ProjectKitchen/BrailleDisplay/CAD Drawings/Braille Cell V2/Combined/ExplodedAssembly_3.FCStd

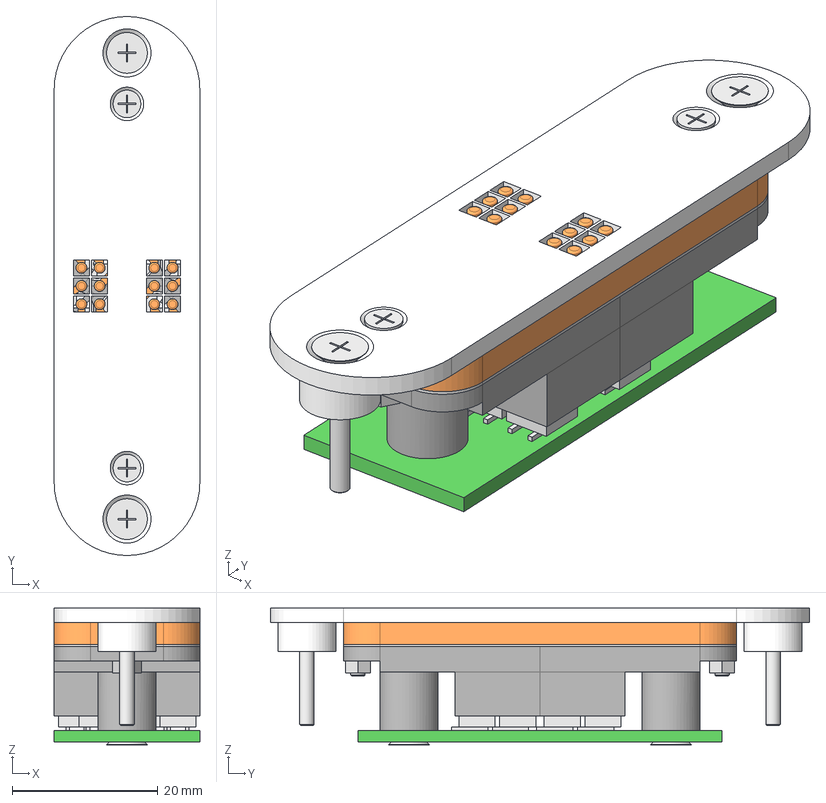
[picture p1: CAD file, 2017-05-22]
CAD Drawings/Braille Cell V2/Combined/ExplodedAssembly_3.FCStd
20.0 x 74.0 x 18.8 mm
PINs
MotorHolder
SCREW
SCREW2
BOLT
BOLT2
TopPlate001
PCB
SCREW003
SCREW004
SCREW005
SCREW006
Motor001
Motor003
Motor005
Motor007
Motor009
Motor011
Motor013
Motor015
Motor017
Motor019
Motor021
Motor023
