ProjectKitchen/BrailleDisplay/CAD Drawings/Braille Cell V2/Combined/ExplodedAssembly.FCStd

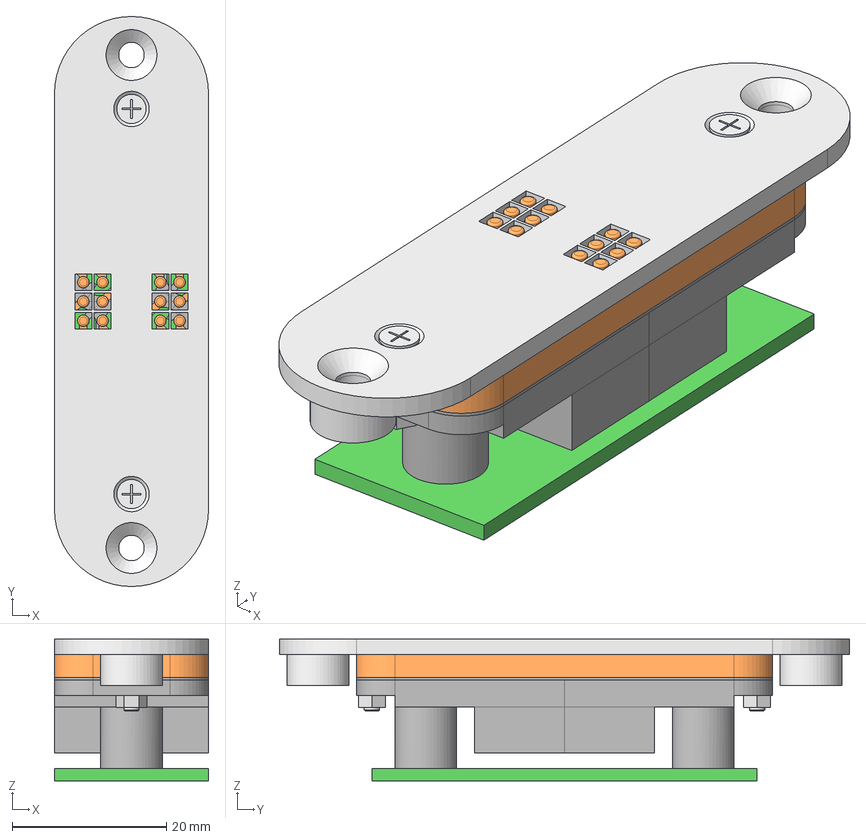
[picture p2: CAD file, 2017-05-22]
CAD Drawings/Braille Cell V2/Combined/ExplodedAssembly.FCStd
20.0 x 74.0 x 18.4 mm
PINs
Lever
MotorHolder
SCREW
SCREW2
BOLT
BOLT2
TopPlate001
PCB
