ProjectKitchen/BrailleDisplay/CAD Drawings/Braille Cell V2/Lever/Lever_1.4.FCStd

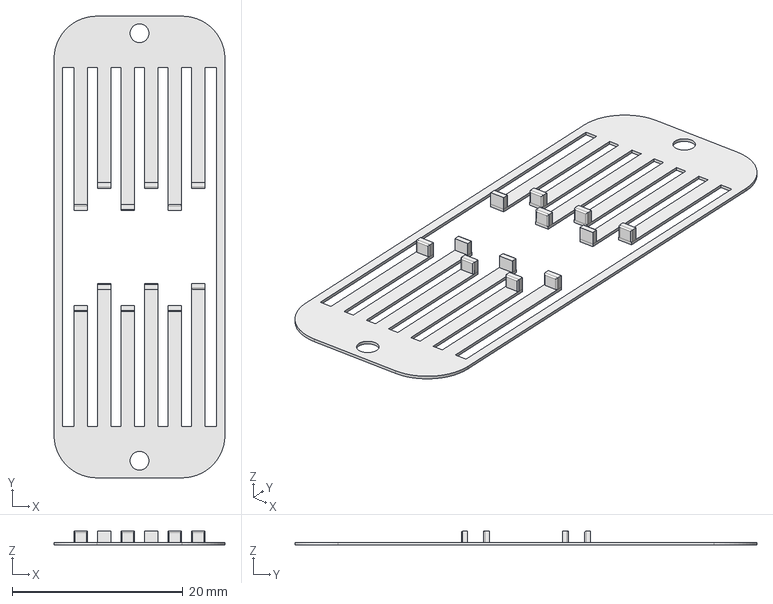
[picture p3: CAD file, 2017-05-22]
CAD Drawings/Braille Cell V2/Lever/Lever_1.4.FCStd
20.0 x 54.0 x 1.60 mm
