ProjectKitchen/BrailleDisplay/CAD Drawings/Braille Cell V2/Motor/Motor_1.1.FCStd

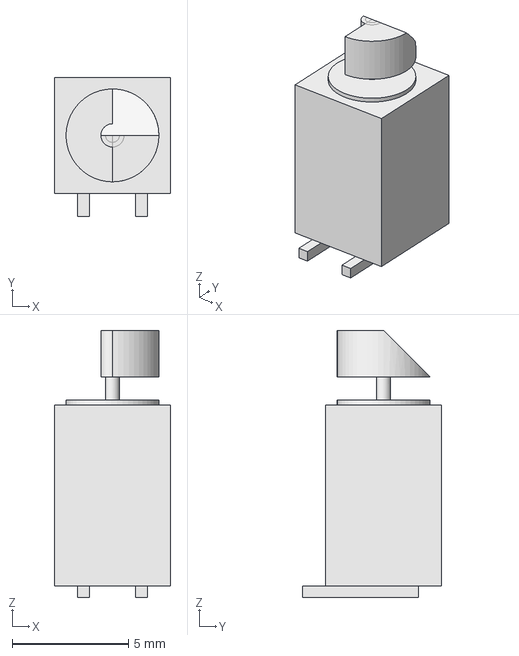
[picture p4: CAD file, 2017-05-22]
CAD Drawings/Braille Cell V2/Motor/Motor_1.1.FCStd
5.00 x 6.00 x 11.5 mm
