ProjectKitchen/BrailleDisplay/CAD Drawings/Braille Cell V2/MotorHolder/MotorHolder_1.2.FCStd

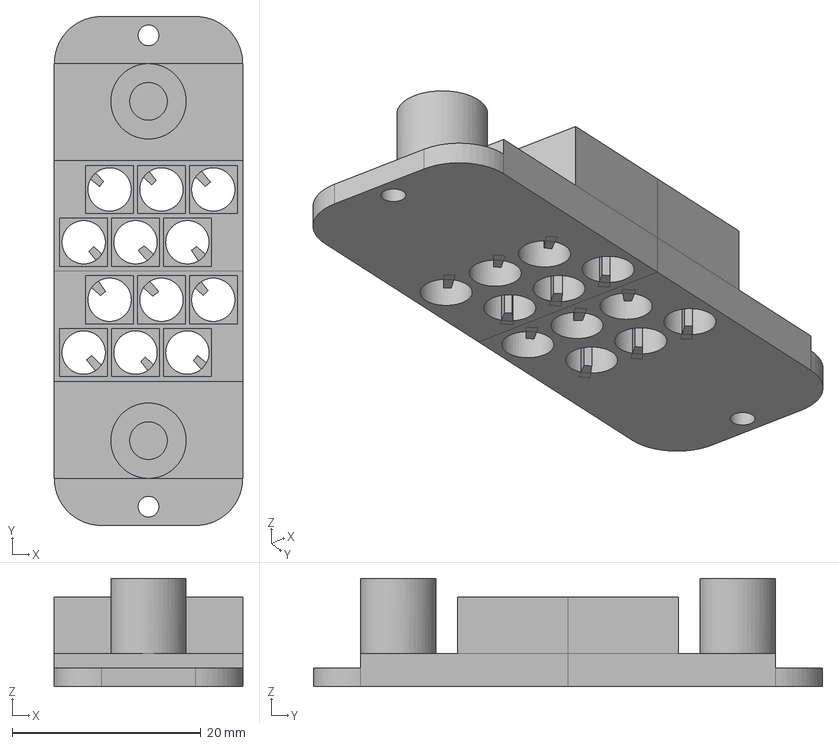
[picture p5: CAD file, 2017-05-22]
CAD Drawings/Braille Cell V2/MotorHolder/MotorHolder_1.2.FCStd
20.0 x 54.0 x 11.5 mm
