ProjectKitchen/BrailleDisplay/CAD Drawings/Braille Cell V2/PCB/PCB.FCStd

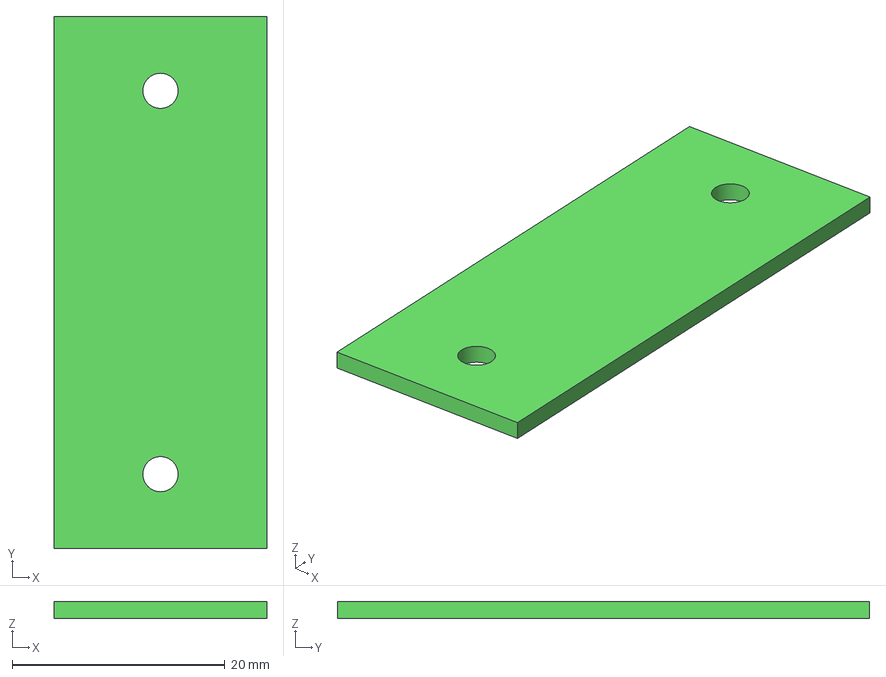
[picture p6: CAD file, 2017-05-22]
CAD Drawings/Braille Cell V2/PCB/PCB.FCStd
20.0 x 50.0 x 1.60 mm
