ProjectKitchen/BrailleDisplay/CAD Drawings/Braille Cell V2/Pins/Pins_2.1.FCStd

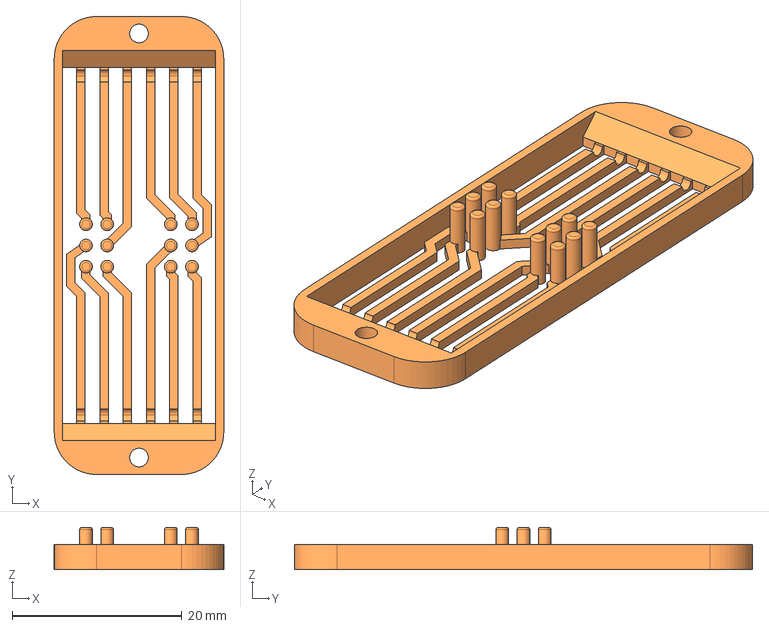
[picture p7: CAD file, 2017-05-22]
CAD Drawings/Braille Cell V2/Pins/Pins_2.1.FCStd
20.0 x 54.0 x 5.00 mm
