ProjectKitchen/BrailleDisplay/CAD Drawings/Braille Cell V2/TopPlate/TopPlate_1.1.FCStd

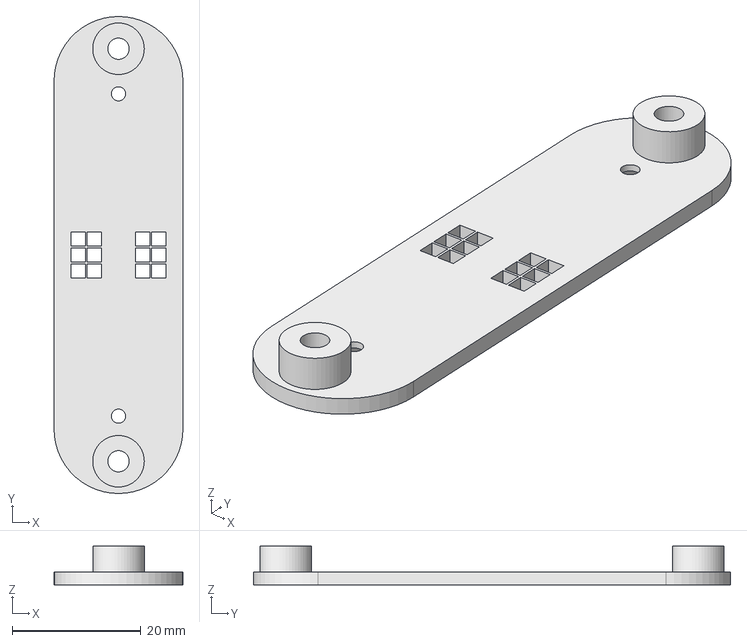
[picture p8: CAD file, 2017-05-22]
CAD Drawings/Braille Cell V2/TopPlate/TopPlate_1.1.FCStd
20.0 x 74.0 x 6.00 mm
