ProjectKitchen/BrailleDisplay/CAD Drawings/Case/Case_Top_2.FCStd

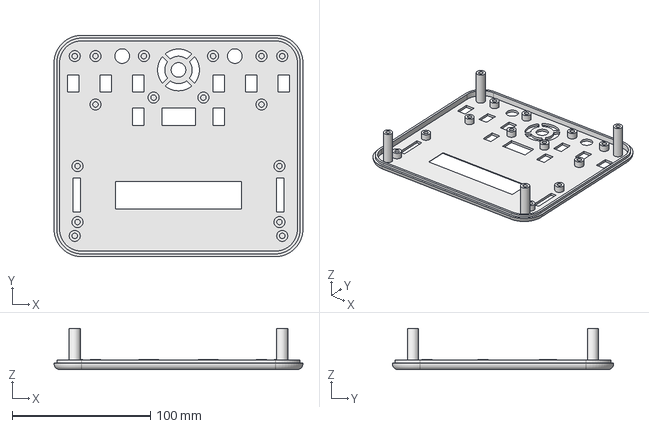
[picture p10: CAD file, 2017-05-22]
CAD Drawings/Case/Case_Top_2.FCStd
180.0 x 160.0 x 30.0 mm
