ProjectKitchen/BrailleDisplay/CAD Drawings/Switch/Switch_InnerPlate_1.0.FCStd

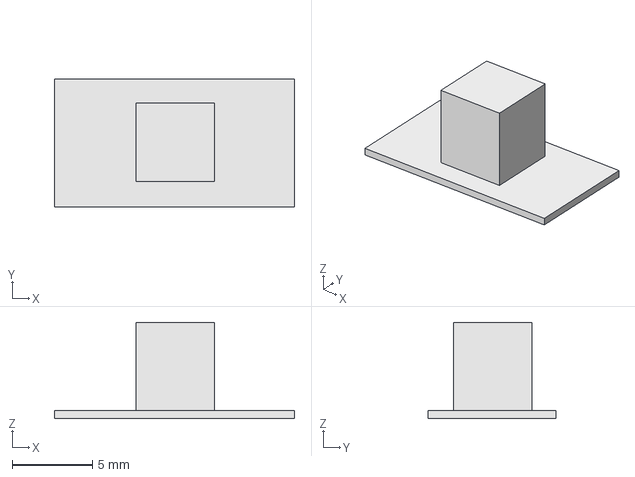
[picture p11: CAD file, 2017-05-22]
CAD Drawings/Switch/Switch_InnerPlate_1.0.FCStd
15.0 x 8.00 x 6.00 mm
