ProjectKitchen/BrailleDisplay/CAD Drawings/WirelessCharger/WirelessChargerPlatform_1.1.FCStd

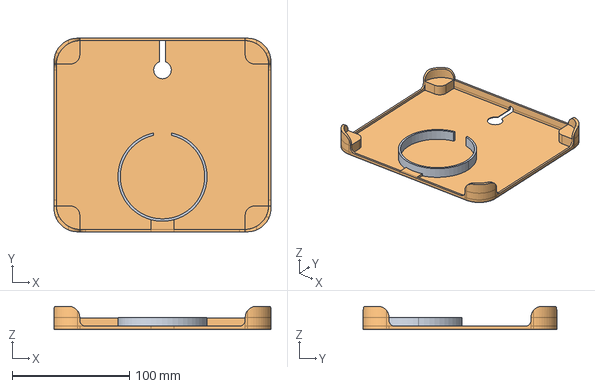
[picture p12: CAD file, 2017-05-22]
CAD Drawings/WirelessCharger/WirelessChargerPlatform_1.1.FCStd
185.0 x 165.0 x 20.0 mm
