ProjectKitchen/BrailleDisplay/CAD Drawings/Buttons/Button_Panning_1.0.FCStd

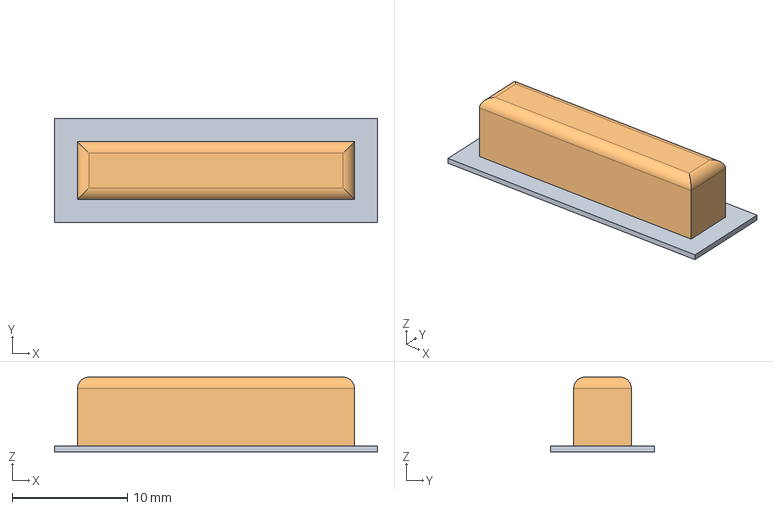
[picture p13: CAD file, 2017-05-22]
CAD Drawings/Buttons/Button_Panning_1.0.FCStd
28.0 x 9.00 x 6.50 mm
