ProjectKitchen/BrailleDisplay/CAD Drawings/Case/Case_Bottom_2.1.FCStd

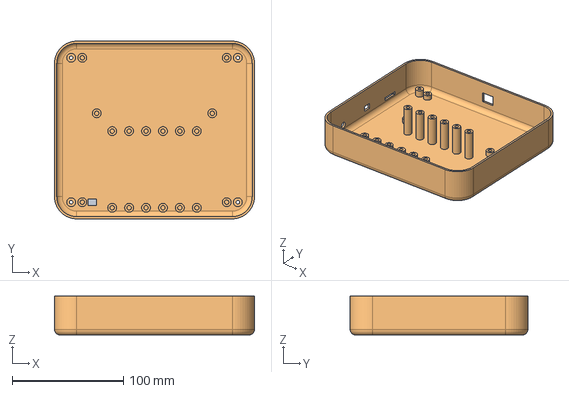
[picture p14: CAD file, 2017-05-22]
CAD Drawings/Case/Case_Bottom_2.1.FCStd
180.0 x 160.0 x 35.0 mm
VibrationMotor
