ProjectKitchen/BrailleDisplay/CAD Drawings/Switch/Switch_OuterPlate_1.0.FCStd

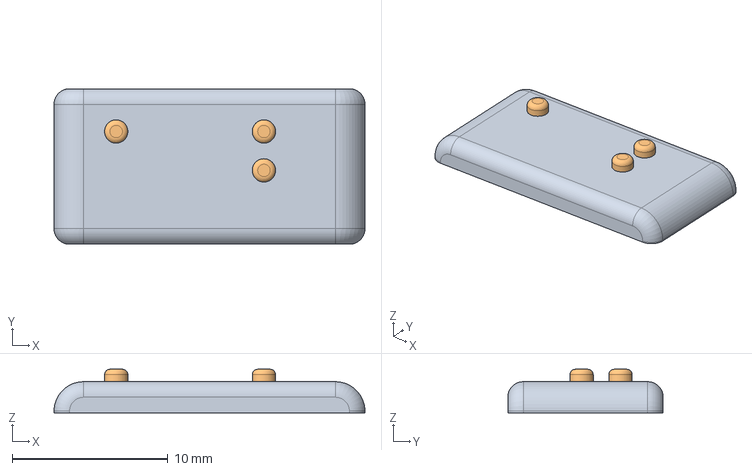
[picture p15: CAD file, 2017-05-22]
CAD Drawings/Switch/Switch_OuterPlate_1.0.FCStd
20.0 x 10.0 x 2.80 mm
