ProjectKitchen/BrailleDisplay/CAD Drawings/Braille Cell V2/Combined/Combined_2.0.FCStd

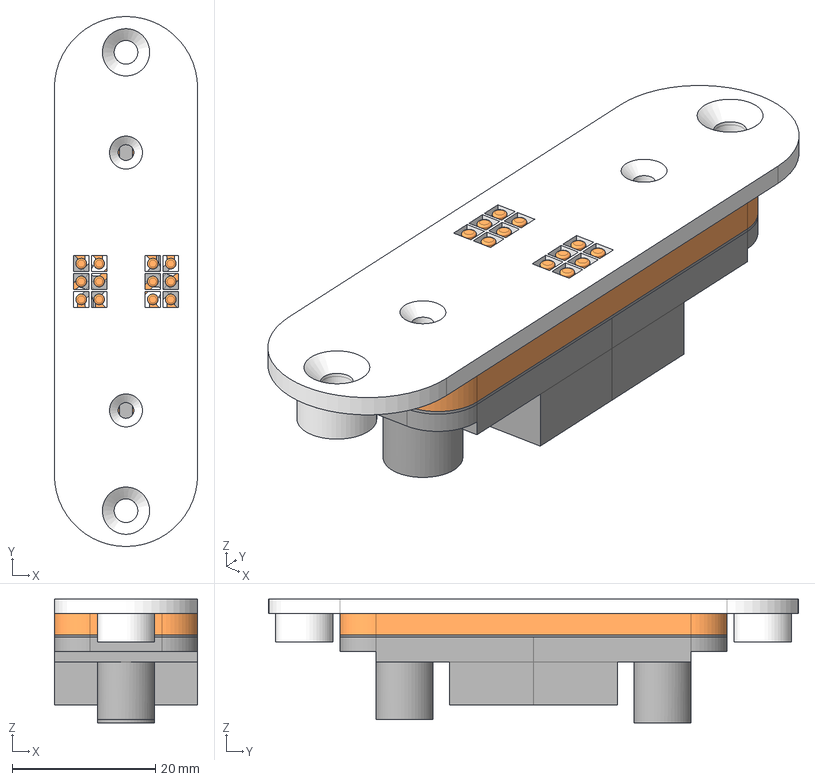
[picture p16: CAD file, 2017-05-22]
CAD Drawings/Braille Cell V2/Combined/Combined_2.0.FCStd
20.0 x 74.0 x 17.3 mm
PINs
Lever
TopPlate001
MotorHolder
