ProjectKitchen/BrailleDisplay/CAD Drawings/Buttons/Button_Space_1.0.FCStd

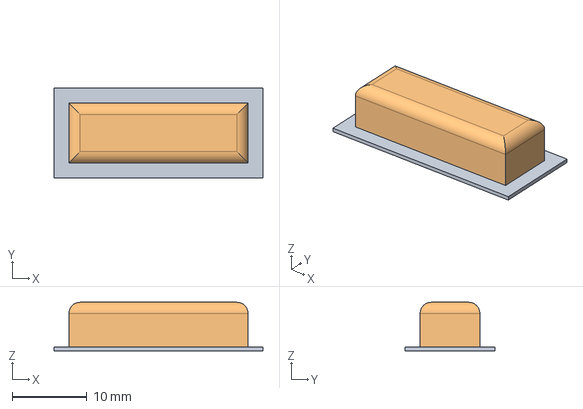
[picture p18: CAD file, 2017-05-22]
CAD Drawings/Buttons/Button_Space_1.0.FCStd
28.0 x 12.0 x 6.50 mm
