ProjectKitchen/BrailleDisplay/CAD Drawings/Buttons/Button_2.0_Braille_Number1.FCStd

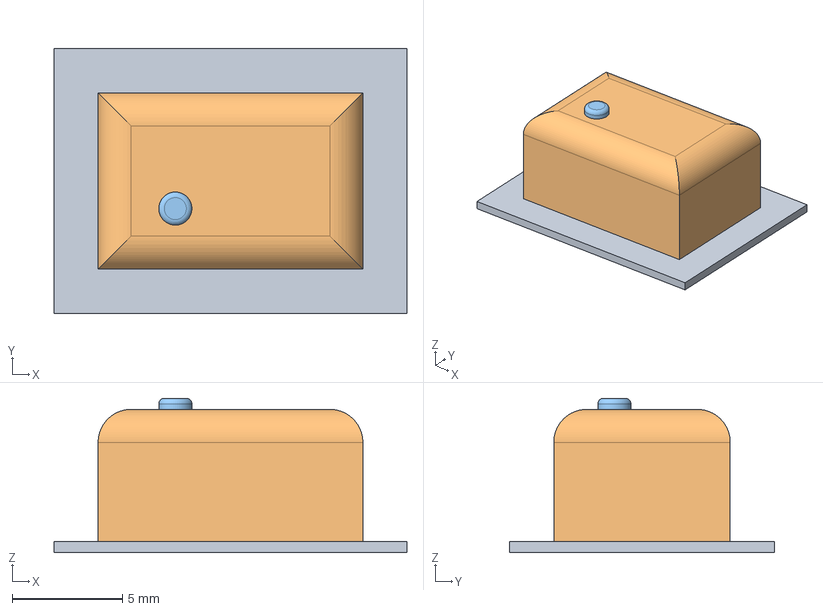
[picture p19: CAD file, 2017-05-22]
CAD Drawings/Buttons/Button_2.0_Braille_Number1.FCStd
16.0 x 12.0 x 7.00 mm
