ProjectKitchen/BrailleDisplay/CAD Drawings/Buttons/Button_Navigation_1.1.FCStd

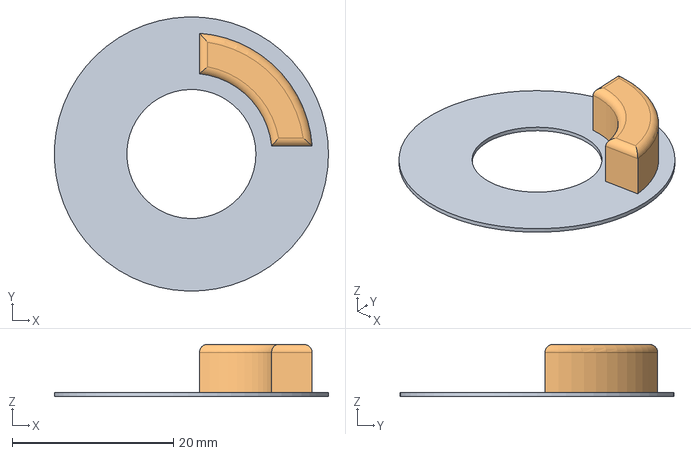
[picture p20: CAD file, 2017-05-22]
CAD Drawings/Buttons/Button_Navigation_1.1.FCStd
34.0 x 34.0 x 6.50 mm
