ProjectKitchen/BrailleDisplay/CAD Drawings/Buttons/Button_Middle_1.0.FCStd

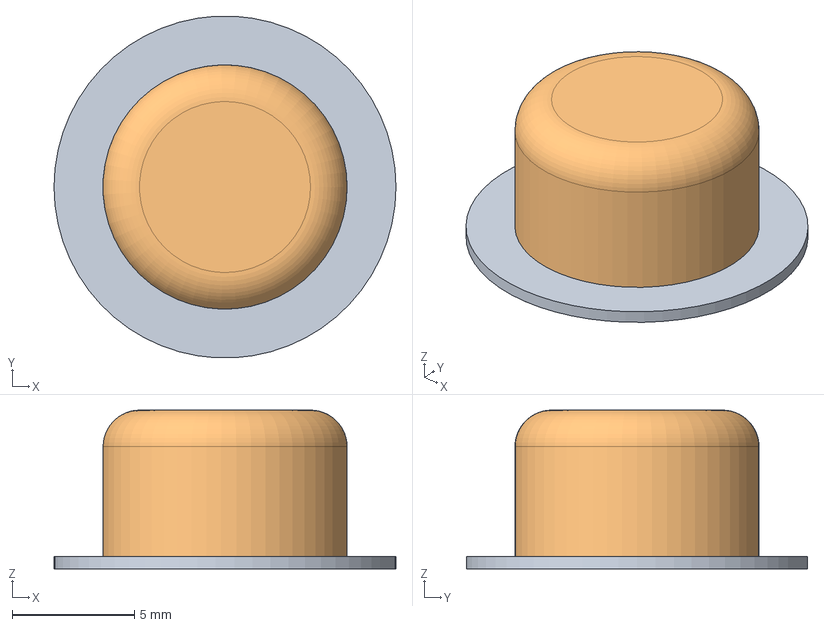
[picture p21: CAD file, 2017-05-22]
CAD Drawings/Buttons/Button_Middle_1.0.FCStd
14.0 x 14.0 x 6.50 mm
