ProjectKitchen/BrailleDisplay/CAD Drawings/Buttons/Button_Navigation_Single_1.1.FCStd

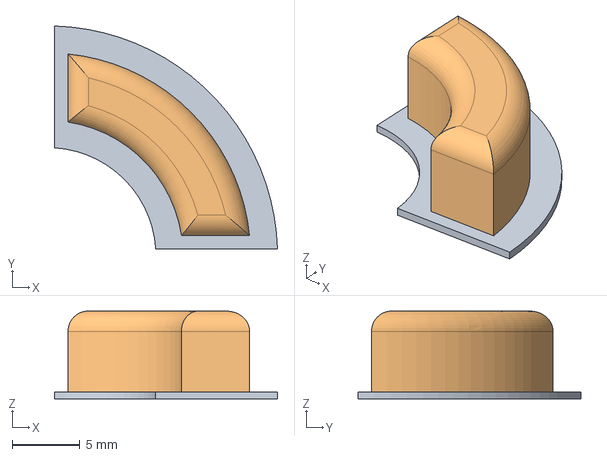
[picture p22: CAD file, 2017-05-22]
CAD Drawings/Buttons/Button_Navigation_Single_1.1.FCStd
16.5 x 16.5 x 6.50 mm
