ProjectKitchen/BrailleDisplay/(list of files, cad)

Other CAD files:
CAD Drawings/Braille Cell V2/Combined/ExplodedAssembly_2.1.FCStd
CAD Drawings/Braille Cell V2/Combined/ExplodedAssembly_2.FCStd
CAD Drawings/Braille Cell V2/Combined/Combined.FCStd
CAD Drawings/Braille Cell V2/Combined/ExplodedView.FCStd
CAD Drawings/Buttons/Button_2.0_Braille_Number8.FCStd
CAD Drawings/Buttons/Button_2.0_Braille_Number3.FCStd
CAD Drawings/Buttons/Button_2.0_Braille_Number4.FCStd
CAD Drawings/Buttons/Button_2.0_Braille_Number6.FCStd
CAD Drawings/Buttons/Button_2.0_Braille_Number5.FCStd
CAD Drawings/Braille Cell V1/Braille_Cell_Combined/BrailleCell.FCStd
CAD Drawings/Braille Cell V1/Braille_Cell_Combined/BrailleCell_ExplodedView.FCStd
CAD Drawings/Braille Cell V1/Lever/Lever 3.stl
CAD Drawings/Braille Cell V1/Motor/Motor.FCStd
CAD Drawings/Braille Cell V1/MotorHolder/MotorHolder_1.1.FCStd
CAD Drawings/Braille Cell V1/Pins/Pins 3.stl
CAD Drawings/Braille Cell V1/TopPlate/TopPlate 1.8.FCStd
CAD Drawings/Braille Cell V1/TopPlate/TopPlateBlank_1.FCStd
CAD Drawings/Braille Cell V2/Bolt/M2_Bolt.FCStd
CAD Drawings/Braille Cell V2/Screw/Screw_M2.FCStd
CAD Drawings/Braille Cell V2/Screw/Screw_M3x16.FCStd
CAD Drawings/Braille Cell V2/Screw/Screw_M3x5.FCStd
