ProjectKitchen/BrailleDisplay/Electronics/RefreshableBrailleDisplay/KeyBoard.brd

## EAGLE design Electronics/RefreshableBrailleDisplay/KeyBoard.brd (2017-05-22)

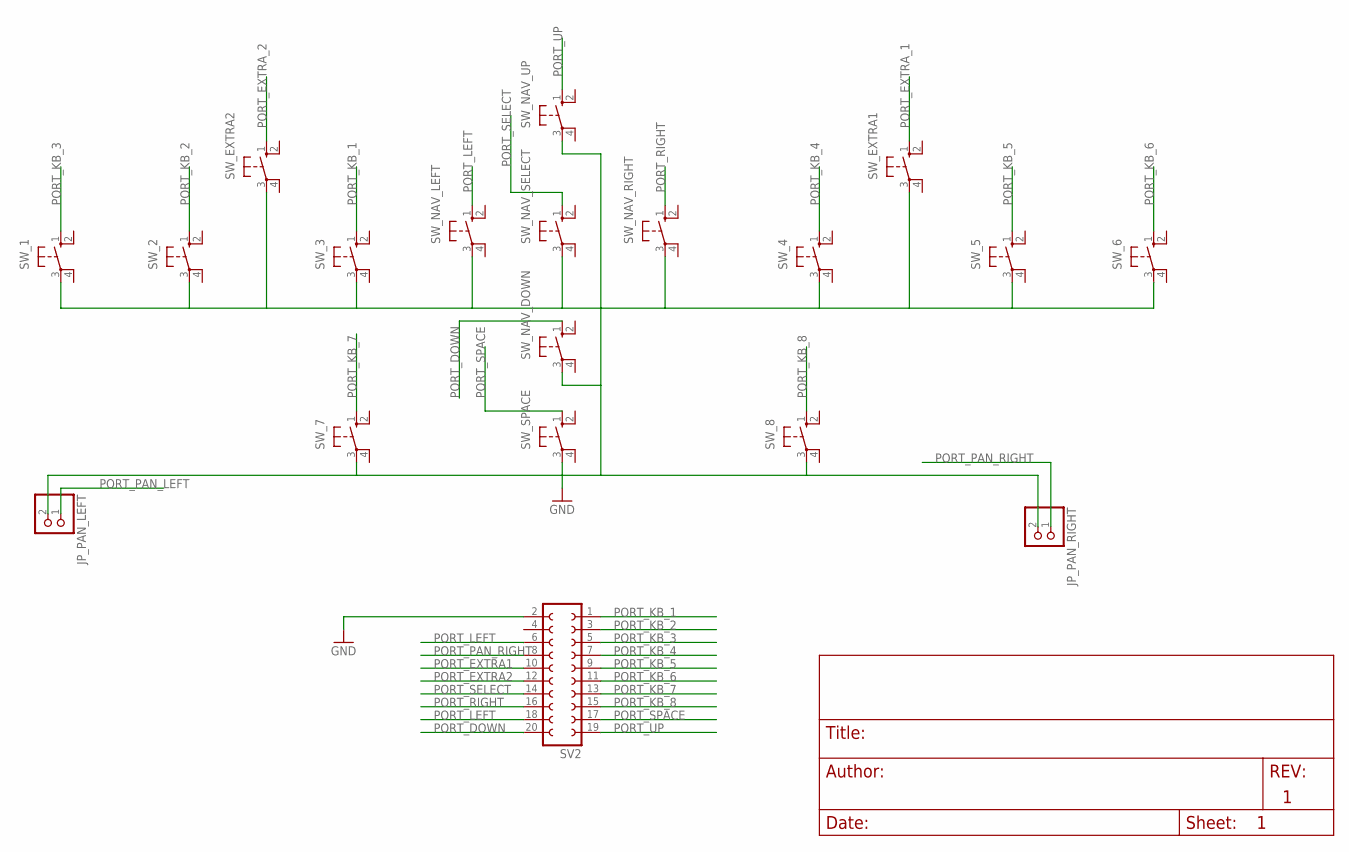
[picture p23: schematic KeyBoard.sch]

Parts:
JP_PAN_LEFT: PINHD-1X2; 1X02
JP_PAN_RIGHT: PINHD-1X2; 1X02
SV2: FE10-2
SW_1, SW_2, SW_3, SW_4, SW_5, SW_6, SW_7, SW_8: 10-XX; B3F-10XX
SW_EXTRA1, SW_EXTRA2: 10-XX; B3F-10XX
SW_NAV_DOWN: 10-XX; B3F-10XX
SW_NAV_LEFT: 10-XX; B3F-10XX
SW_NAV_RIGHT: 10-XX; B3F-10XX
SW_NAV_SELECT: 10-XX; B3F-10XX
SW_NAV_UP: 10-XX; B3F-10XX
SW_SPACE: 10-XX; B3F-10XX

Connections:
GND: JP_PAN_LEFT.2, JP_PAN_RIGHT.2, SV2.2, SW_1.3, SW_2.3, SW_3.3, SW_4.3, SW_5.3, SW_6.3, SW_7.3, SW_8.3, SW_EXTRA1.3, SW_EXTRA2.3, SW_NAV_DOWN.3, SW_NAV_LEFT.3, SW_NAV_RIGHT.3, SW_NAV_SELECT.3, SW_NAV_UP.3, SW_SPACE.3
PORT_DOWN: SV2.20, SW_NAV_DOWN.1 (S)
PORT_EXTRA1: SV2.10
PORT_EXTRA2: SV2.12
PORT_EXTRA_1: SW_EXTRA1.1 (S)
PORT_EXTRA_2: SW_EXTRA2.1 (S)
PORT_KB_1: SV2.1, SW_3.1 (S)
PORT_KB_2: SV2.3, SW_2.1 (S)
PORT_KB_3: SV2.5, SW_1.1 (S)
PORT_KB_4: SV2.7, SW_4.1 (S)
PORT_KB_5: SV2.9, SW_5.1 (S)
PORT_KB_6: SV2.11, SW_6.1 (S)
PORT_KB_7: SV2.13, SW_7.1 (S)
PORT_KB_8: SV2.15, SW_8.1 (S)
PORT_LEFT: SV2.6, SV2.18, SW_NAV_LEFT.1 (S)
PORT_PAN_LEFT: JP_PAN_LEFT.1
PORT_PAN_RIGHT: JP_PAN_RIGHT.1, SV2.8
PORT_RIGHT: SV2.16, SW_NAV_RIGHT.1 (S)
PORT_SELECT: SV2.14, SW_NAV_SELECT.1 (S)
PORT_SPACE: SV2.17, SW_SPACE.1 (S)
PORT_UP: SV2.19, SW_NAV_UP.1 (S)

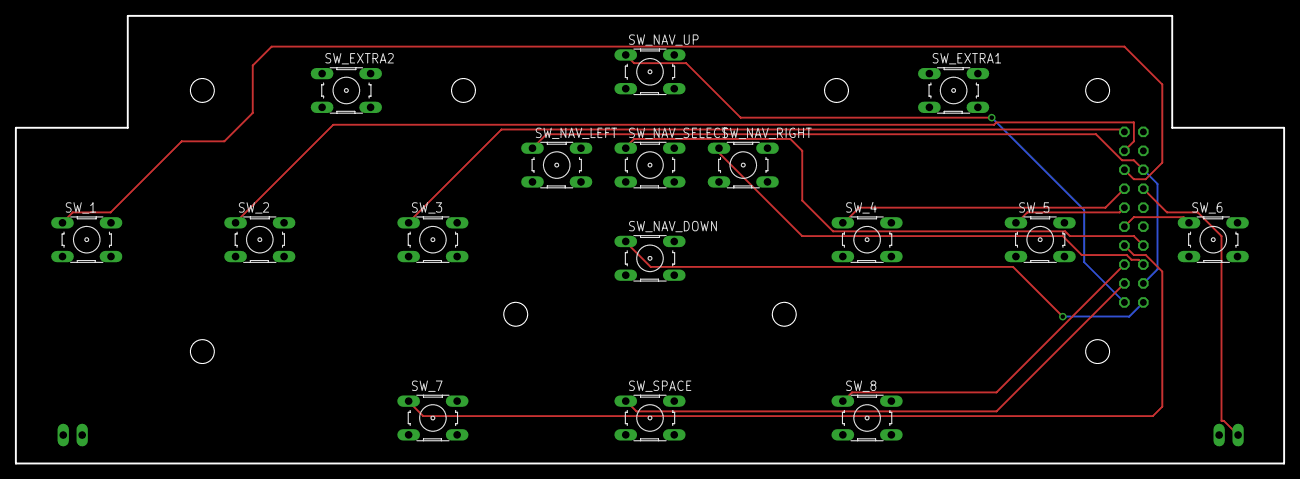
[picture p24: board KeyBoard.brd from above]

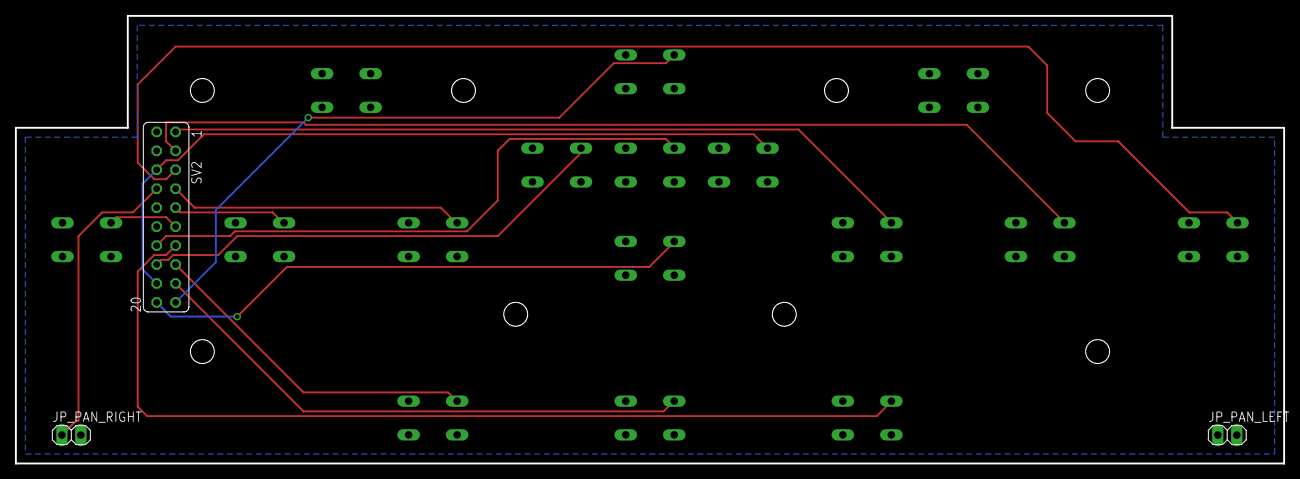
[picture p25: board KeyBoard.brd from below]

Board: 2 copper layers, 170.0 x 60.0 mm, 19 parts (3 on the bottom side), 16 nets.
