ProjectKitchen/BrailleDisplay/Electronics/RefreshableBrailleDisplay/MainBoard.brd

## EAGLE design Electronics/RefreshableBrailleDisplay/MainBoard.brd (2017-05-22)

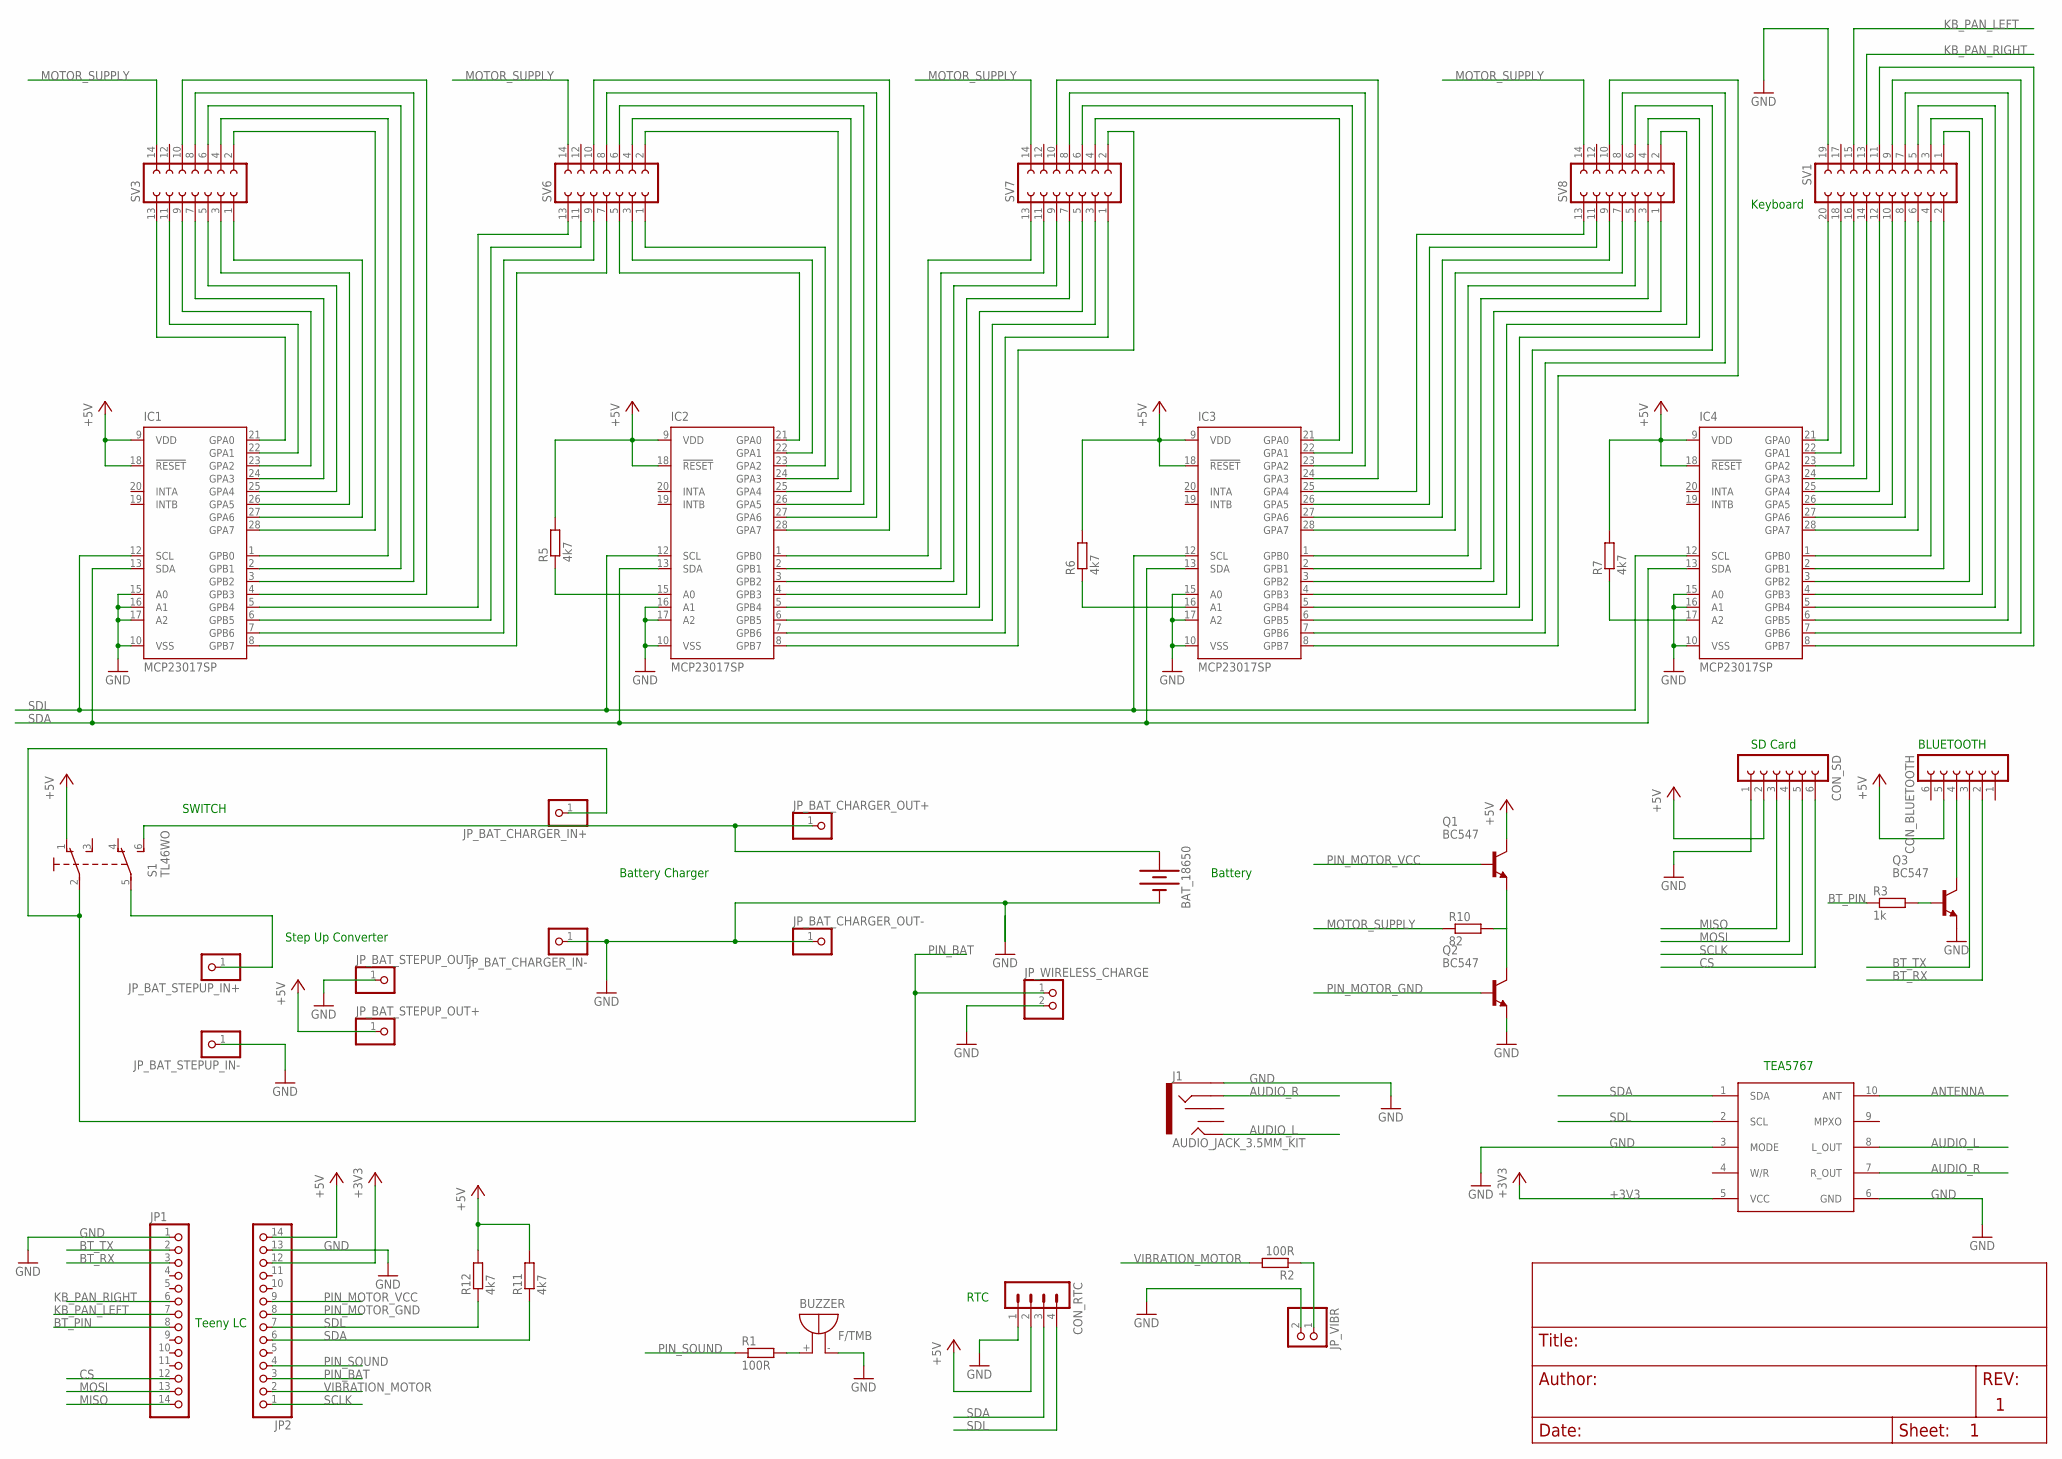
[picture p26: schematic MainBoard.sch]

Parts:
BAT_18650: BATTERY-18650; BATTERY_18650-HOLDER
BUZZER: F/TMB
CON_BLUETOOTH: FE06-1; FE06
CON_RTC: MA04-1
CON_SD: FE06-1; FE06
IC1, IC2, IC3, IC4: MCP23017SP; DIL28-3
J1: AUDIO_JACK_3.5MM_KIT; AUDIO-JACK-KIT
JP1, JP2: PINHD-1X14; 1X14
JP_BAT_CHARGER_IN+: PINHD-1X1; 1X01
JP_BAT_CHARGER_IN-: PINHD-1X1; 1X01
JP_BAT_CHARGER_OUT+: PINHD-1X1; 1X01
JP_BAT_CHARGER_OUT-: PINHD-1X1; 1X01
JP_BAT_STEPUP_IN+: PINHD-1X1; 1X01
JP_BAT_STEPUP_IN-: PINHD-1X1; 1X01
JP_BAT_STEPUP_OUT+: PINHD-1X1; 1X01
JP_BAT_STEPUP_OUT-: PINHD-1X1; 1X01
JP_VIBR: PINHD-1X2; 1X02
JP_WIRELESS_CHARGE: PINHD-1X2; 1X02
Q1, Q2, Q3: BC547; TO92
R1, R2: 100R; R1206
R3: 1k; R1206
R5, R6, R7, R11, R12: 4k7; R1206
R10: 82; R1206
S1: TL46WO; TL4XWO
SV1: FE10-2
SV3, SV6, SV7, SV8: FE07-2
TEA5767: TEA5767BREAKOUT; TEA5767MM2

Connections:
+3V3: JP2.12, TEA5767.5 (VCC)
+5V: CON_BLUETOOTH.5, CON_RTC.2, CON_SD.2, IC1.9 (VDD), IC1.18 (!RESET), IC2.9 (VDD), IC2.18 (!RESET), IC3.9 (VDD), IC3.18 (!RESET), IC4.9 (VDD), IC4.18 (!RESET), JP2.14, JP_BAT_STEPUP_OUT+.1, Q1.3 (C), R5.2, R6.2, R7.2, R11.2, R12.2, S1.1 (O)
ANTENNA: TEA5767.10 (ANT)
AUDIO_L: J1.TIP, TEA5767.8 (L_OUT)
AUDIO_R: J1.RING, TEA5767.7 (R_OUT)
BAT_PLUS: BAT_18650.PWR@1 (+), JP_BAT_CHARGER_OUT+.1, S1.6 (S1)
BT_PIN: JP1.8, R3.1
BT_RX: CON_BLUETOOTH.2, JP1.3
BT_TX: CON_BLUETOOTH.3, JP1.2
CS: CON_SD.6, JP1.12
GND: BAT_18650.GND@1 (-), BUZZER.-, CON_RTC.1, CON_SD.1, IC1.10 (VSS), IC1.15 (A0), IC1.16 (A1), IC1.17 (A2), IC2.10 (VSS), IC2.16 (A1), IC2.17 (A2), IC3.10 (VSS), IC3.15 (A0), IC3.17 (A2), IC4.10 (VSS), IC4.15 (A0), IC4.16 (A1), J1.SLEEVE, JP1.1, JP2.13, JP_BAT_CHARGER_IN-.1, JP_BAT_CHARGER_OUT-.1, JP_BAT_STEPUP_IN-.1, JP_BAT_STEPUP_OUT-.1, JP_VIBR.2, JP_WIRELESS_CHARGE.2, Q2.1 (E), Q3.1 (E), SV1.19, TEA5767.3 (MODE), TEA5767.6 (GND)
KB_PAN_LEFT: JP1.7, SV1.15
KB_PAN_RIGHT: JP1.6, SV1.13
MISO: CON_SD.3, JP1.14
MOSI: CON_SD.4, JP1.13
MOTOR_SUPPLY: R10.1, SV3.14, SV6.14, SV7.14, SV8.14
unnamed: IC4.25 (GPA4), SV1.12
unnamed: Q1.1 (E), Q2.3 (C), R10.2
unnamed: IC1.5 (GPB4), SV6.13
unnamed: IC4.26 (GPA5), SV1.10
unnamed: IC4.27 (GPA6), SV1.8
unnamed: IC4.28 (GPA7), SV1.6
unnamed: IC4.1 (GPB0), SV1.4
unnamed: IC4.24 (GPA3), SV1.14
unnamed: IC4.23 (GPA2), SV1.16
unnamed: IC4.22 (GPA1), SV1.18
unnamed: IC4.21 (GPA0), SV1.20
unnamed: IC4.2 (GPB1), SV1.2
unnamed: IC4.3 (GPB2), SV1.1
unnamed: IC4.4 (GPB3), SV1.3
unnamed: IC4.5 (GPB4), SV1.5
unnamed: IC4.6 (GPB5), SV1.7
unnamed: IC4.7 (GPB6), SV1.9
unnamed: IC4.8 (GPB7), SV1.11
unnamed: IC1.6 (GPB5), SV6.11
unnamed: IC3.4 (GPB3), SV8.2
unnamed: CON_BLUETOOTH.4, Q3.3 (C)
unnamed: IC2.2 (GPB1), SV7.11
unnamed: Q3.2 (B), R3.2
unnamed: BUZZER.+, R1.2
unnamed: JP_VIBR.1, R2.1
unnamed: JP_BAT_STEPUP_IN+.1, S1.5 (P1)
unnamed: IC1.7 (GPB6), SV6.9
unnamed: IC1.8 (GPB7), SV6.7
unnamed: IC3.21 (GPA0), SV7.4
unnamed: IC2.22 (GPA1), SV6.3
unnamed: IC2.25 (GPA4), SV6.4
unnamed: IC2.26 (GPA5), SV6.6
unnamed: IC2.27 (GPA6), SV6.8
unnamed: IC2.28 (GPA7), SV6.10
unnamed: IC2.1 (GPB0), SV7.13
unnamed: IC2.3 (GPB2), SV7.9
unnamed: IC2.4 (GPB3), SV7.7
unnamed: IC2.5 (GPB4), SV7.5
unnamed: IC1.24 (GPA3), SV3.7
unnamed: IC1.23 (GPA2), SV3.9
unnamed: IC1.22 (GPA1), SV3.11
unnamed: IC1.25 (GPA4), SV3.5
unnamed: IC1.26 (GPA5), SV3.3
unnamed: IC1.27 (GPA6), SV3.1
unnamed: IC1.28 (GPA7), SV3.2
unnamed: IC1.1 (GPB0), SV3.4
unnamed: IC1.2 (GPB1), SV3.6
unnamed: IC1.3 (GPB2), SV3.8
unnamed: IC1.4 (GPB3), SV3.10
unnamed: IC4.17 (A2), R7.1
unnamed: IC3.16 (A1), R6.1
unnamed: IC2.15 (A0), R5.1
unnamed: IC3.22 (GPA1), SV7.6
unnamed: IC2.7 (GPB6), SV7.1
unnamed: IC1.21 (GPA0), SV3.13
unnamed: IC2.8 (GPB7), SV7.2
unnamed: IC2.6 (GPB5), SV7.3
unnamed: IC2.24 (GPA3), SV6.2
unnamed: IC2.21 (GPA0), SV6.5
unnamed: IC2.23 (GPA2), SV6.1
unnamed: IC3.23 (GPA2), SV7.8
unnamed: IC3.26 (GPA5), SV8.11
unnamed: IC3.6 (GPB5), SV8.6
unnamed: IC3.8 (GPB7), SV8.10
unnamed: IC3.7 (GPB6), SV8.8
unnamed: IC3.5 (GPB4), SV8.4
unnamed: IC3.3 (GPB2), SV8.1
unnamed: IC3.2 (GPB1), SV8.3
unnamed: IC3.1 (GPB0), SV8.5
unnamed: IC3.28 (GPA7), SV8.7
unnamed: IC3.27 (GPA6), SV8.9
unnamed: IC3.25 (GPA4), SV8.13
unnamed: IC3.24 (GPA3), SV7.10
PIN_BAT: JP2.3, JP_BAT_CHARGER_IN+.1, JP_WIRELESS_CHARGE.1, S1.2
PIN_MOTOR_GND: JP2.8, Q2.2 (B)
PIN_MOTOR_VCC: JP2.9, Q1.2 (B)
PIN_SOUND: JP2.4, R1.1
SCLK: CON_SD.5, JP2.1
SDA: CON_RTC.3, IC1.13 (SDA), IC2.13 (SDA), IC3.13 (SDA), IC4.13 (SDA), JP2.6, R11.1, TEA5767.1 (SDA)
SDL: CON_RTC.4, IC1.12 (SCL), IC2.12 (SCL), IC3.12 (SCL), IC4.12 (SCL), JP2.7, R12.1, TEA5767.2 (SCL)
VIBRATION_MOTOR: JP2.2, R2.2

Notes on the sheet:
Keyboard
Battery
RTC
SD Card
SWITCH
BLUETOOTH
Step Up Converter
Battery Charger
Teeny LC
TEA5767

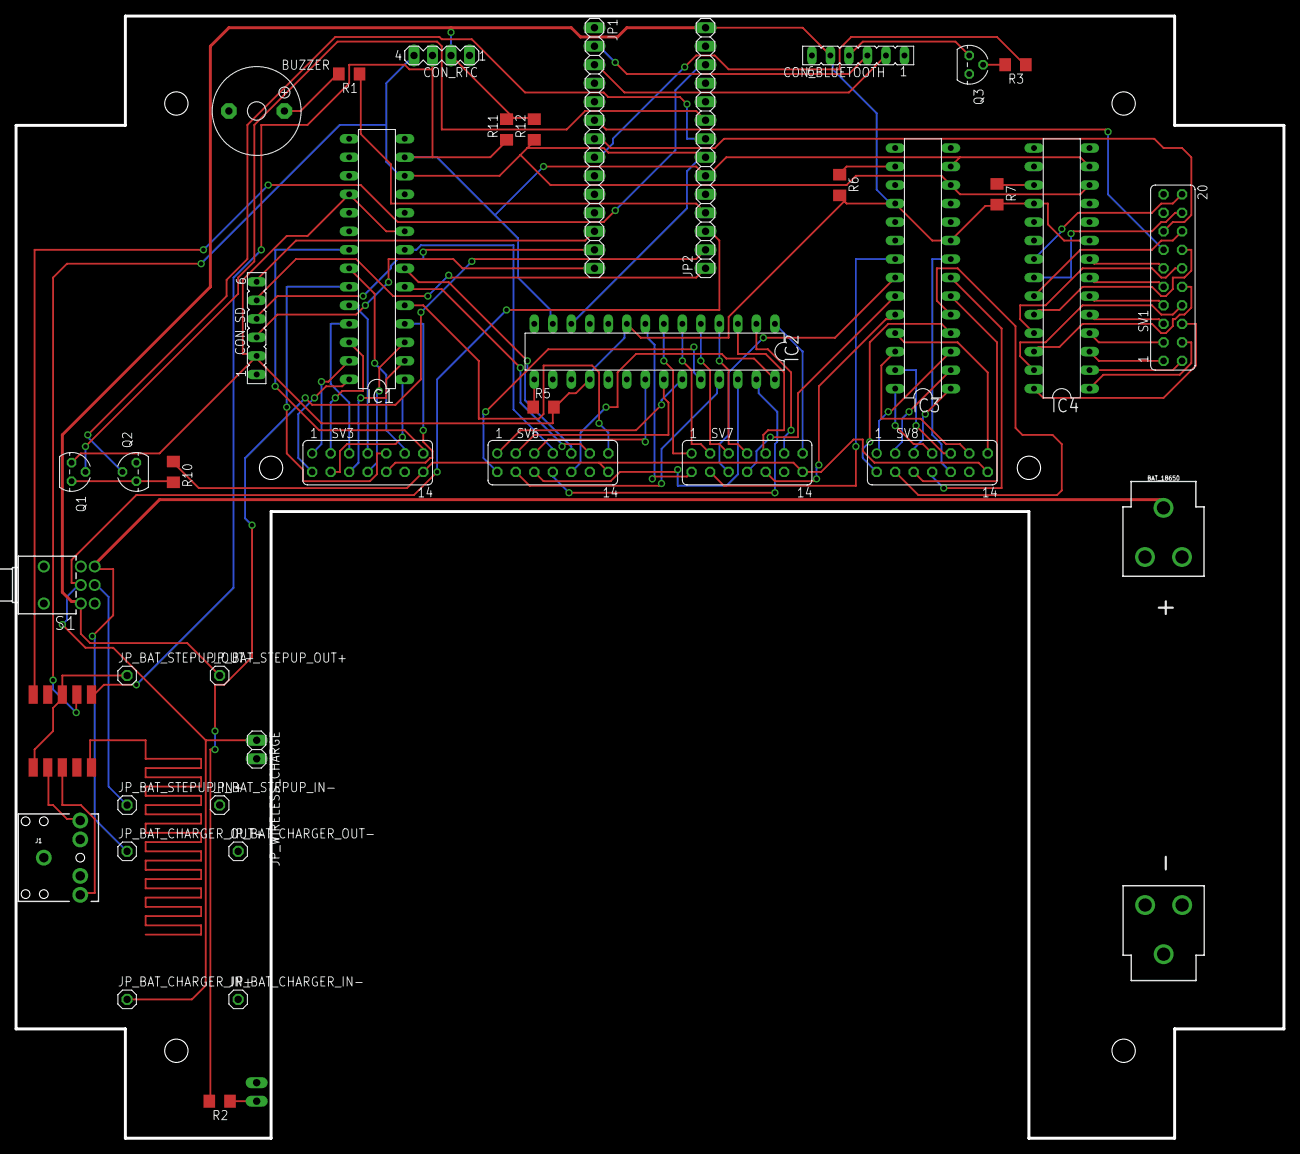
[picture p27: board MainBoard.brd from above]

Board: 2 copper layers, 174.0 x 154.0 mm, 41 parts (1 on the bottom side), 96 nets.
