ProjectKitchen/BrailleDisplay/Electronics/RefreshableBrailleDisplay/Braille_Cell.brd

## EAGLE design Electronics/RefreshableBrailleDisplay/Braille_Cell.brd (2017-05-22)

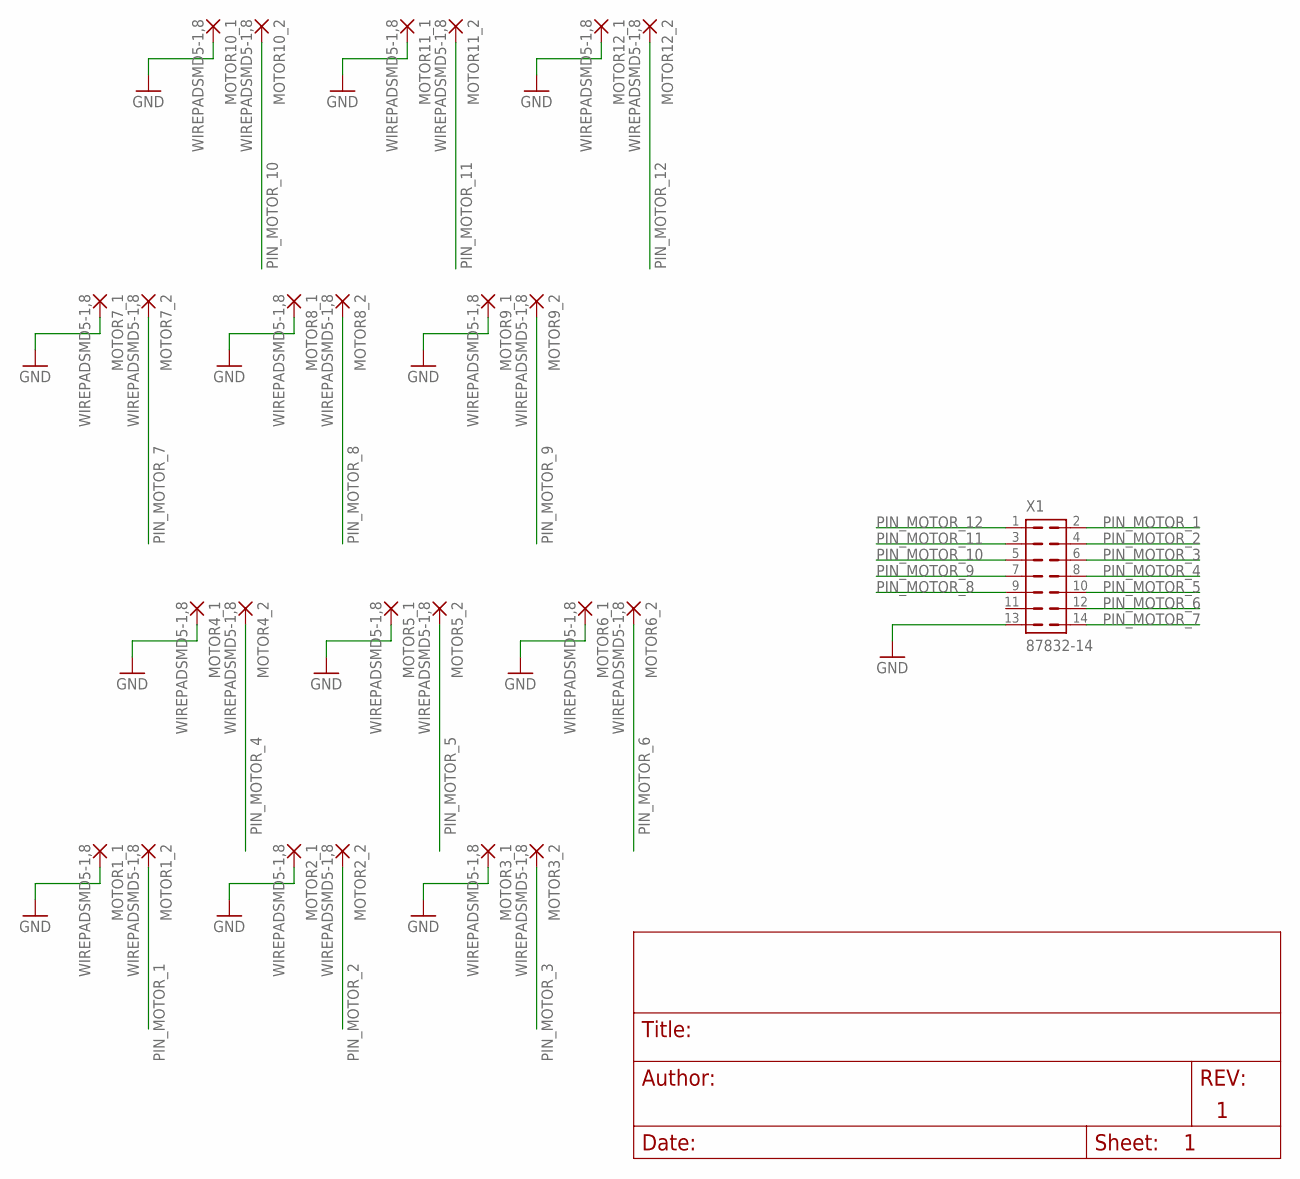
[picture p28: schematic Braille_Cell.sch]

Parts:
MOTOR1_1, MOTOR1_2, MOTOR2_1, MOTOR2_2, MOTOR3_1, MOTOR3_2, MOTOR4_1, MOTOR4_2, MOTOR5_1, MOTOR5_2, MOTOR6_1, MOTOR6_2, MOTOR7_1, MOTOR7_2, MOTOR8_1, MOTOR8_2, MOTOR9_1, MOTOR9_2, MOTOR10_1, MOTOR10_2, MOTOR11_1, MOTOR11_2, MOTOR12_1, MOTOR12_2: WIREPADSMD5-1,8; 5-1,8
X1: 87832-14

Connections:
GND: MOTOR1_1.1, MOTOR2_1.1, MOTOR3_1.1, MOTOR4_1.1, MOTOR5_1.1, MOTOR6_1.1, MOTOR7_1.1, MOTOR8_1.1, MOTOR9_1.1, MOTOR10_1.1, MOTOR11_1.1, MOTOR12_1.1, X1.13
PIN_MOTOR_1: MOTOR1_2.1, X1.2
PIN_MOTOR_2: MOTOR2_2.1, X1.4
PIN_MOTOR_3: MOTOR3_2.1, X1.6
PIN_MOTOR_4: MOTOR4_2.1, X1.8
PIN_MOTOR_5: MOTOR5_2.1, X1.10
PIN_MOTOR_6: MOTOR6_2.1, X1.12
PIN_MOTOR_7: MOTOR7_2.1, X1.14
PIN_MOTOR_8: MOTOR8_2.1, X1.9
PIN_MOTOR_9: MOTOR9_2.1, X1.7
PIN_MOTOR_10: MOTOR10_2.1, X1.5
PIN_MOTOR_11: MOTOR11_2.1, X1.3
PIN_MOTOR_12: MOTOR12_2.1, X1.1

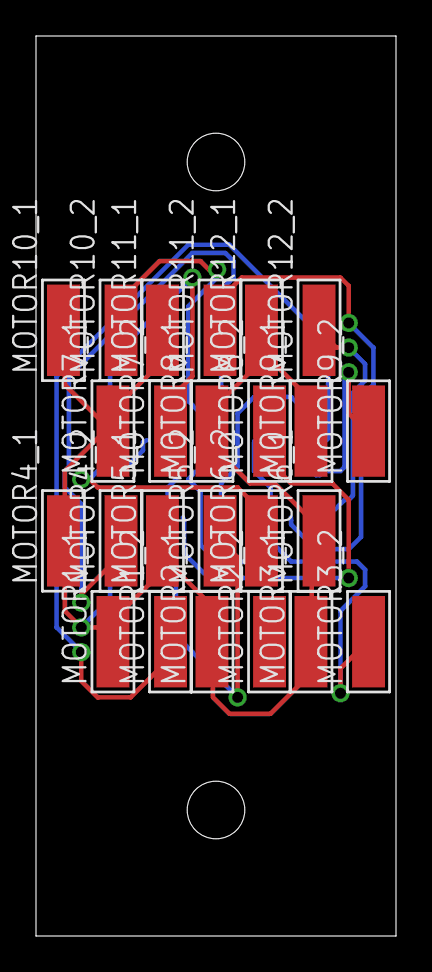
[picture p29: board Braille_Cell.brd from above]

Board: 2 copper layers, 20.0 x 50.0 mm, 25 parts (1 on the bottom side), 13 nets.
