ProjectKitchen/BrailleDisplay/(notices)

Notices in the files:
Software/Firmware/Braille_Firmware/BrailleCell.h:
This software is free software: you can redistribute it and/or modify
it under the terms of the GNU General Public License as published by
the Free Software Foundation, either version 3 of the License, or
(at your option) any later version.
parts and their libraries:
SparkFun-Batteries: Licensing: Creative Commons ShareAlike 4.0 International - https://creativecommons.org/licenses/by-sa/4.0
